rin67630/Soft-Power-MPPT/Hardware/Soft-Power Hardware Principles.md

# Soft-Power Hardware Principles

Instrumentation control is provided by:  
1. A convenience power output that can be controlled by software between 5V and 12V that can switched on and off by software as required. This can be used for any discretionary purpose by the user such as to charge a smaller secondary battery, control devices/track sun...
2. Two control lines for relays or FET-modules to switch user loads by software.
3. The analog input of the ESP8266 and enough processing capacity of the microcontroller remain available to include user-defined measurement functionalities.

## The hardware involved is using:

1. Several generally available buck converters, depending on panel size voltage, controlled by injecting voltage into their CV potentiometers to provide efficient power conversions.
2. An ESP8266 microcontroller to optimize solar panel power harvesting, control the buck converters and the charging process for various battery chemistries; and provide WiFi connectivity and a cloud statistical dashboard.
3. Relatively few connections with power measurement modules and other components make it possible to build the hardware without a PCB, using just a prototyping board.
4. The low cost materials should be procured for far less than $50.

## Schematic diagrams:

Unfortunately, there is no " one size fits all " hardware.  
There is currently no buck converter having at the same time a very low quiescent current, providing high power and being able to manage relatively high input voltage (see next chapter about converters used). For that reason, the design will consist of a base module, containing low-power, very low quiescent current buck converters, able to handling input power up to 20W.  
That base module can be used alone.  Cf: Soft Power 1xINA226 Minimum.pdf
To handle more power, an optional external buck converter can be added. The software will use the low-power modules in the low-power range and switch over to the more powerful buck converter as a power increases. Cf: Soft Power 1xINA3221 w Power Extension.pdf  
For people already having a SCC, but without Dashboard and extensive reporting abilities I provide a plain data logger. Cf. Soft Power 1xINA3221 Passive Logger.pdf.

All three hardware versions use the same base module. 

The operating concept is described in SoftPower Schematic Analysis.md

## Buck converters used:

The HW613 and D-SUN converter have a very low quiescent current, far below 1mA.
The HW613 buck converter is preferred in almost all respects, it is one of the few providing an "enable" input pad and is more easily tweaked to get CV injection, but it only supports an input voltage up to 24V.
The D-SUN buck converter accepts an input up to 40V which is required for 36Voc panels.

The "Fine" Red buck converter is a plain fixed 5V buck converter with the advantage of an inbuilt USB connector. It fits well under the Wemos module.
If the USB port is not a requirement, the smaller and more efficient HW613 modules can be used instead.

The SZBK07 buck converter is an option to boost the power from 20W to 300W for projects requiring more energy.
The HW636 buck converter is an option to boost the power from 20W to 250W and to manage panels up to 60Voc. 

## Preparation of the modules for injection:

The HW613 and D-SUN require soldering a wire to a really tiny trim potentiometer to allow voltage injection. That requires a bit of soldering experience and a fine tip. It is doable, even for an old man with some early signs of Parkinson.

1. HW613 - preferred for panels up to 24Voc
  
Another view on the module sowing better the injection point:  

2. D-SUN - for panels up to 40Voc

3. SZBK07 - mid-power option for up to 300W
  
4. HW636 - high voltage option for panels up to 60Voc 


## ESP8266 microcontroller:

You need to use an ESP8266, model 12E. The best is to use the Wemos D1 mini, which is the most convenient to use, since it has a smaller footprint and provide the ability to stack an OLED display on it.  
  
The D1 Mini exists also in the Pro-version, which provides more EEPROM and the possibility to use an external antenna. That more expensive version is recommended but not required.  
I have also made builds using the Lolin Node MCU and they are surely also doable using the Adafruit HUZZAH.

Almost all outputs of the ESP will be used:  
- D1 and D2 are providing the I2C functionality used by the power measurement module INA3221.
- D3 and D4 can control up to two relays or two FET modules to control power loads by software.
- D7 enables the convenience user power output.
- D8 enables the mid-power option when the charging power exceeds 15W.
- D0 enables U1, the low-power buck converter when the charging power is less than 15W (D0 has a specificity to be enabled automatically at power on).
- D6 is the PWM-output to control the voltage of the convenience user power output.
- D5 is the PWM-output to control the voltage of either U1 or U6, depending on the charging power.
- A0 is the 0 to 3V analog input left to the user for measuring tasks, or used to measure the panel voltage or the convenince output.

## OLED display option:

An oled display is nice to have. It adds only ~2 mA to the overall consumption.  
Two versions are supported:
a) The 64x48 pixel Wemos display hat, which conveniently can be just pushed on top of the WEMOS D1  
b) The bigger and more flexible 128x64 pixel display, which must be connected separately by connecting:  
-  Vcc to +3.3V
-  SCL to D1
-  SDA to D2
-  GND to GND

## INA3221 power measurement module:

The INA3221 power measurement module provides three independent measurement channels each of them consisting of voltage, current, power measurement.
- channel 1 is used to measure the photovoltaic module
- channel 2 is used to measure the main battery
- channel 3 is used to measure the convenience output/secondary battery.  
N.B. There are two different versions of INA3221 on the market. You should avoid the pink one, for which all three measurement channels are connected together at V+.  
The right black one is the right one to go, it has independent inputs and is also less expensive:  
 
N.B. The INA3221 has a measurement range from 0 to 1.5A with an accuracy of 0.5mA, which is fine for the operation up to 20W.  
For the extended power range up to 200W using a SZBK07 we will have to replace the shunts with 0.01 Ohm shunts resulting in a measurement range from 0 to 15A with an accuracy of 5mA.
If you want to push the SZBK07 to the theoretical maximum of 300W (20A), you can use 0.005 Ohm shunts, I would however recommend and prefer using an external shunt in that case.  

## INA226 power measurement module(s):
The INA226 power measurement module provides only one measurement channel, but they are more versatile.  
They support up to 36V as well can be easily purchased with either 0.1 Ohm or 0.01 Ohm shunts. 
The 0.1 Ohm version can handle a measurement range from 0 to 0.8A with an accuracy of 0.25mA, which is fine for the operation up to 10W.  
The 0.01 Ohm version can handle a measurement range from 0 to 8A with an accuracy of 0.25mA, which is fine for the operation up to 100W.
For an extended power range up to 200W using a SZBK07 we will have to replace the shunts with 0.005 Ohm shunts resulting in a measurement range from 0 to 15A with an accuracy of 5mA.

## Calculate the R4 resistance.
If you use the A0 input, to measure the panel voltage, you need a resitor R4 to reduce the voltage to the 0..3.2V input of the Wemos D1.
the rule to calculate that resistor is simple: 100K for every volt exceeding 3.2V. So if you want the panel range of 23.2V you put 20x100k=2M, if you want the panel range of 43.2V you put 40x100k=4M, which is not a standard, so you will use 3.9M instead, giving you a range of 0..42.2V.

### Addressing:  
If you use more than one module, you must provide different I2C addresses, by soldering a small tin bridge:  
  

### Increasing current measuring range:  
The original shunts can be relatively easy unsoldered by generously adding tin to both ends, then heating the ends in short sequence and shifting the resistor away with the soldering tip. You can do it! Even I can, as an old man with beginning Parkinson! 

## Current injection

The technique of current injection is described in document https://github.com/rin67630/Soft-Power-MPPT/blob/main/Hardware/About%20CV%20Injection.md. The bypass filter consists of a 6.8k or 8,2K resistor and a 1 or 10 microfarad condenser, the injection current resistor is a 500K trim potentiometer, which can be replaced by a fixed resistor, once the project is stable, currently the value is around 63K, excepted for the high voltage module which needs 3,3K.  

## Connectors

The prototyping board is equipped with following screw terminals :

**Left connector on INA3221**  
- Panel_in   negative.  
- Panel_in   positive.  
- Power_Output to SZBK Input positive

**Mid connector on INA3221** 
- Power_Input from Ideal Diode positive  
- Battery_Out positive  

**Right connector on INA3221**  
- Convenience output wo (does this mean without?) current monitoring positive  
- Convenience output with current monitoring positive  
- Convenience output negative  

**On Board**  
- Enable to SZBK07  
- CV Injection to SZBK07  

**I2C female header**  
- +3,3V  
- GND  
- SCL  
- SDA  

**2x Relay/FET control male headers**  
- 0 to 3.3V to control first relay  
- 0 to 3.3V to control second relay  
- Gnd.  
- +5V.  

**User defined measurement female header**  
- 0 to 3.3V analog input.  
- 0 to 3.3V to control first relay  
- Gnd  
- +5V.  

**12V Fan connector**

## Performance

- Quiescent current from the 12V battery ~25mA, mainly from the WiFi chip
- Low-Power Efficiency at 1W 92%
- Low-Power Efficiency at 10W 95%
- Mid Power Efficiency at 200W 97%

A reduction to <1mA at night could be realized with a sleep option.  
I do not want it for myself, since my user measurement functions on the same ESP8266 must go on permanently.

Enjoy!
