rin67630/Soft-Power-MPPT/Hardware/Open Hardware Link.md

https://oshwlab.com/lazlo.lebrun/soft-power-universal-pcb-prototype
