rin67630/Soft-Power-MPPT/Software/5_User Handbook Serial.md

# Operation on the serial line
The preferred operation -and by far the most powerful- runs in the cloud over Thinger.io.  
The precondition is however to have an Internet access. Without that I have provided a fallback operating mode over the serial line.   
The serial line is also the way to go upon problems with connecting to your dashboard.  
For that, you can connect the ESP over its USB port to a terminal program of your computer or of your smart phone.  

# Bootlog

## Successful
Upon starting the ESP you will get a boot log with diagnostic messages:  
```
0⸮~?⸮4⸮Ҷ
⸮⸮OAqr⸮⸮

ESP-Karajan at work,Serial @ 9600 Baud
Trying to connect

state: 5 -> 0 (0)
rm 0
del if0
usl
mode : null
mode : sta(d8:f1:5b:11:0e:ac)
add if0

.RSSI: 31 dBm
.RSSI: 31 dBm
.RSSI: 31 dBm
.RSSI: 31 dBm
.RSSI: 31 dBm
scandone
state: 0 -> 2 (b0)
.RSSI: 31 dBm
state: 2 -> 3 (0)
state: 3 -> 5 (10)
add 0
aid 5
cnt 

connected with [SSID], channel 1
dhcp client start...
ip:192.168.188.32,mask:255.255.255.0,gw:192.168.188.1
.RSSI: -53 dBm
OTA Ready
 MAC address: D8:F1:5B:11:0E:AC
Hostname: ESP-110EAC 
UDP ports: 4214, 4215
Now is Monday, 08 February 2021 21:42:32. Epoch =1612816952

pm open,type:2 0
```
_n.b.  
the gibberish first line is normal after a reboot._

Many lines are automatically generated, in between you however get interesting information:  
- RSSI: 31 dBm is generally the indication, that the connection on that frequency failed  
  RSSI: -53 dBm is a realistic radio level  
- ip:192.168.188.32 is a valuable information over the IP of your device.  
- Hostname: ESP-110EAC (not matching the hostname of your upload) means the Router has refused the host name, the reason for that is very probably,  
  that you already have another device with the same hostname in the network.  
- you only get the UDP ports listed if the operation was successful.  
- You only get the current date, if the ESP was able to reach the NTP server.  

## Unsuccessful
this is an example of an unsuccessful Wi-Fi connection attempt.  
```
ESP-Karajan at work,
Serial @ 9600 Baud
mode : sta(3c:61:05:d1:53:ce) + softAP(3e:61:05:d1:53:ce)
add if0

.....scandone
no wifihot found, reconnect after 1s
reconnect
.....SSID or PASS?
scandone
del if0
mode : softAP(3e:61:05:d1:53:ce)
running offline, back in the 70's
RSSI: 31 dBm
Now is 00:00:12. The Epoch is:         12
Date is Thursday, 01 January 1970
I need the date(dd/mm/yyyy) and time(hh:mm:ss)
```
In that case "no wifihot found" means, the SSID wifihot was not detected.  
Else it would list the router and attempt several connections, giving up after the third attempt, if your password does not match  
Another example with an existing SSID, but the wrong credentials:  
```
ESP-Karajan at work,Serial @ 9600 Baud
Trying to connect

mode : sta(d8:f1:5b:11:0e:ac)
add if0

.RSSI: 31 dBm
.RSSI: 31 dBm
.RSSI: 31 dBm
.RSSI: 31 dBm
.RSSI: 31 dBm
scandone
state: 0 -> 2 (b0)
.RSSI: 31 dBm
state: 2 -> 3 (0)
state: 3 -> 5 (10)
add 0
aid 1
cnt 
.RSSI: -51 dBm
.RSSI: -50 dBm
.RSSI: -52 dBm
.RSSI: -53 dBm
.RSSI: -52 dBm
.RSSI: -52 dBm
state: 5 -> 2 (2a0)
rm 0
.RSSI: 31 dBm
.RSSI: 31 dBm
reconnect
state: 2 -> 0 (0)
scandone
state: 0 -> 2 (b0)
state: 2 -> 3 (0)
state: 3 -> 5 (10)
add 0
aid 1
cnt 
.RSSI: -50 dBm
.RSSI: -50 dBm
.RSSI: -50 dBm
.RSSI: -51 dBm
.RSSI: -51 dBm
.

Bad SSID or PASS?
state: 5 -> 0 (0)
rm 0
del if0
usl
mode : null
force slp enable,type: 2
fpm open,type:2 0

Running offline, back in the 70's
Now is Thursday, 01 January 1970 08:00:18. Epoch =     28818

Please enter date & time (dd/mm/yyyy hh:mm:ss) in the serial monitor, followed by [return]
```
If the connection fails AND you never had an Internet connection and have no RTC shield, you will be requested to enter the current date and time, which is essential for proper operation of Soft-Power's statistic reports.  
You must then enter the date and time manually in order to proceed.  

The system answers with:  
```
I have understood 5/2/2021 18:48:0
Now is 18:48:00. The Epoch is: 1612464480
Date is Thursday, 05 January 2021
```
Now, your serial port is ready to receive commands.

In order to put the maximum of functionality into scarce memory of the microcontroller, there is no verbose menu.  
Instead you have a choice of single character commands, from which you can however enter several in one line, they will be executed in sequence.  

## One-shot reports

'S' Issues a status report, e.g.:  
```
Daily Report for 
Sunday, 07 February 2021 
Hour|   Ah    |    V    |    W    |
00  | -00.033 | +12.376 | -00.405 |
01  | -00.031 | +12.376 | -00.383 |
02  | -00.031 | +12.368 | -00.384 |
03  | -00.032 | +12.368 | -00.391 |
04  | -00.031 | +12.368 | -00.388 |
05  | -00.031 | +12.360 | -00.387 |
06  | -00.032 | +12.360 | -00.402 |
07  | -00.032 | +12.360 | -00.394 |
08  | -00.009 | +12.400 | -00.115 |
09  | +00.022 | +12.440 | +00.275 |
10  | +00.036 | +12.480 | +00.445 |
11  | +00.262 | +12.984 | +03.402 |
12  | +00.596 | +13.760 | +08.206 |
13  | +00.712 | +13.168 | +09.375 |
14  | +00.392 | +12.953 | +05.080 |
15  | +00.233 | +12.896 | +03.002 |
16  | +00.131 | +12.769 | +01.674 |
17  | -00.007 | +12.648 | -00.092 |
18  | -00.028 | +12.608 | -00.357 |
19  | -00.027 | +12.584 | -00.346 |
20  | -00.028 | +12.568 | -00.358 |
21  | -00.030 | +12.557 | -00.378 |
22  | -00.030 | +12.544 | -00.378 |
23  | -00.030 | +12.536 | -00.371 |
Extra hours 25:H-1, 26:today, 27:D-1, 28:D-2..
25  | -00.030 | +12.536 | -00.371 |
26  | +01.970 | +12.096 | +23.828 |
27  | +01.970 | +12.096 | +23.828 |
28  | +01.970 | +12.096 | +23.828 |
29  | +01.970 | +12.096 | +23.828 |
30  | +01.970 | +12.096 | +23.828 |
```
'T' Returns the time
```
Mon Feb  8 22:09:11 2021
```
In the example above, we already have used 's' an extender mentioning that you want to get a periodical report.  

## Periodical reports
Periodical reports can be printed every second, every minute, every hour, and even every day.  
They can also be used in the serial plotter from the Arduino IDE to generate time series graphs.  

### Setting the pace for periodical reports
The pace is given with a low case extender:  
's', 'm', 'h', 'd' staying for every second, minutely, hourly, daily.  
Once the pace for periodical reports is given, it stays valid for every report called after, until another pace is choosen or a '#' stop command is entered.  

### Periodical reports
currently the following periodical reports are available (more to come)
- 'E' Energy plot  
```
Ah:+00.000 Panel:-9.640 V-10:02.552 Amp:-0.029 Watt:-00.358
Ah:+00.000 Panel:-9.640 V-10:02.552 Amp:-0.029 Watt:-00.358
Ah:+00.000 Panel:-9.640 V-10:02.552 Amp:-0.029 Watt:-00.358
Ah:+00.000 Panel:-9.640 V-10:02.552 Amp:-0.029 Watt:-00.358
```
The same plot called from Arduino's IDE serial plotter:  
 
_n.b.  
The serial plotter of the Arduino IDE has only one Y-Axis range. In order to optimize the presentation, panel and battery voltages are issued -10 V: 3V means 13V..._

- 'W' Weather plot
Temp:-07.2 Hum:73.0 Press:1002 WindSpeed:5.7 Direction:50
Temp:-07.2 Hum:73.0 Press:1002 WindSpeed:5.7 Direction:50
Temp:-07.2 Hum:73.0 Press:1002 WindSpeed:5.7 Direction:50
Temp:-07.2 Hum:73.0 Press:1002 WindSpeed:5.7 Direction:50

- '~' returns a radio report
WiFi Plot :
Mode: STA
PHY mode: N
Channel: 1
AP id: 0
Status: 5
Auto connect: 1
SSID (10): [SSID]
Passphrase (8): [Password]
BSSID set: 0
's~' issues the same report, but followed with a signal strength line every second, so you can follow where you get the best (less negative) signal:

```
### Control commands
From the serial menu, you can control several operations of Soft-Power.

'+' or '-' increases or decreases in small steps the setpoint of the battery voltage
'>' or '<' increases or decreases in coarse steps the setpoint of the battery voltage
A0 stops the auxiliary output
A3.3 starts the auxiliary output at 3.3V (or any of the voltage specified up to 9.0V)

### Display control commands
You will be able to control which information is displayed on the OLED Display:  
- '0' switch of the display

t.b.continued.
