rin67630/Soft-Power-MPPT/Hardware/Sourcing.md

# Sourcing 

this file is given for convenience. I am not affiliated in any way with AliExpress, and do not even recommend them, but they have enough choice to be able to sell almost anything I have been using. Many items sell by quantities. If you are not tinkering a lot, you are probably better off buying locally just what you need.

Prototyping boards: https://www.aliexpress.com/item/32588853051.html  
Screw terminals: https://www.aliexpress.com/item/32807534570.html and https://www.aliexpress.com/item/1005001725925575.html  
Heat Sinks: https://www.aliexpress.com/item/32825341178.html and https://www.aliexpress.com/item/32825417247.html  

Low power buck converters: https://www.aliexpress.com/item/4000938525410.html  
or https://www.aliexpress.com/item/32979661350.html (less efficient, less powerful, but 40v input voltage instead of 24V of the HW613)  
60V buck converter: https://www.aliexpress.com/item/4001282565135.html  
High power buck converter: https://www.aliexpress.com/item/32933666759.html  
Ideal diode: https://www.aliexpress.com/item/32977096276.html  
Temperature switch: https://www.aliexpress.com/item/4000683400658.html  
Fan: https://www.aliexpress.com/item/32640103358.html (12v, 2pin)  
60V buck converter: https://www.aliexpress.com/item/32843426443.html

INA3221: https://www.aliexpress.com/item/4000480784866.html  
INA226 up to 0.8 A: https://www.aliexpress.com/item/33005541425.html  
or INA226 up to 8A https://www.aliexpress.com/item/32833590942.html  
High Power shunts: https://www.aliexpress.com/item/4001233004428.html  
SMD Shunts: https://www.aliexpress.com/item/32368758351.html   

Wemos D1 mini: https://www.aliexpress.com/item/32651747570.html  
or Wemos D1 mini Pro: https://www.aliexpress.com/item/1005001621776421.html  
64x48 pixel OLED: https://www.aliexpress.com/item/32801063529.html  
or 128x64 pixel OLED https://www.aliexpress.com/item/32796086867.html  

Resistor Kit 30 values: https://www.aliexpress.com/item/32475181535.html  
10uF capacitors: https://www.aliexpress.com/item/32952790541.html  
Trim potentiometers: https://www.aliexpress.com/item/1005001649630759.html

2 Channel Relay Module Board: https://www.aliexpress.com/item/4000418641261.html  
MOS Driver Module: https://www.aliexpress.com/item/1005001645129771.html  

Color wires: I use to tear-off old parallel printer or VGA cables from the scrapyard.  
They yet have good old quality copper wires, not the crap you buy today made of CC Aluminium!
