rin67630/Soft-Power-MPPT/Software/3_Configuration Instructions.md

# Configuration instructions
Warning: a few settings must interactivity match between the configuration at Thinger.io and the configuration file in the ESP.
So, if you are not an expert, may I strongly recommend not to change the username, nor to change the HOST_NAME unless you get familiar with the operation of the whole ecosystem.

The software is written in such a way that you can use it just upon defining your options in the folder a0_Parameters.  
If you are not familiar with the code, *this (and eventually Thinger_Dashboard) are the only folder that you should change*:  

## Parameter list
If you have several devices, change the HOST_NAME and let it be "Soft_Power", which must be matching the device name that you created at Thinger.io
The HOST_NAME also matches the device content of the default dashboard.  

Begin with populationg your credentials
#### WiFi credentials
If you already have successfully used your ESP device in your Wi-Fi network, you can skip that block, else...  

WifI: for the very first run with a new ESP or on a new WiFi network, remove the // from the next line and provide real SSID and PASS credentials. 

//#define ERASE_WIFI_CREDENTIALS 

Enter your Wi-Fi credentials 
´´´
#define ERASE_WIFI_CREDENTIALS 
#define WIFI_SSID          "SPLabs"
#define WIFI_PASS          "!Dev#45219"
#define wifiMaxTries       20
#define wifiRepeatInterval 500
´´´
Once you have made a successful connection to your Wi-Fi network, you can return to the configuration and restore the // from the next line. 
´´´
//#define ERASE_WIFI_CREDENTIALS 
´´´
this will speed up the next boot procedures, since it will not need to perform the credentials handshake anymore.
If you want you also can remove the sensitive information from your sketch.

#### Thinger.io credentials
The next step will be entering your credentials at Thinger.io:
´´´
#define THINGER_USERNAME           "SoftPower1"       
#define THINGER_DEVICE_CREDENTIALS "Device credentials"    
#define THINGER_DEVICE HOST_NAME   
´´´
n.b. please note the first line is your username, and the second one is the credentials of the device, *not the password of your web account* at Thinger.io.
Leave the third line unchanged it takes over the device hostname, that you defined right at the beginning of the configuration.

#### PoenWeatherMaps.org credentials
You should have opened a a free account at openweathermap.org, and have noted the map app ID.  
You can also search and call your city, then note its location ID "https://openweathermap.org/city/2928809" (the last number after the slash)  

Enter now these credentials together with your time zone information:  
#define OPEN_WEATHER_MAP_APP_ID      "208085abb5a3859d1e32341d6e1f9079"
#define OPEN_WEATHER_MAP_LOCATION_ID "2820158"
#define OPEN_WEATHER_MAP_LANGUAGE    "en"
#define OPEN_WEATHER_MAP_UNITS       "metric"

### Time zones
#define NTP_SERVER "de.pool.ntp.org"
#define MYTZ TZ_Europe_Paris
#define TZ   1                              // (utc+) TZ in hours

Then proceed with the hardware configuration:
### Hardware configuration
- #define WEATHER_SOURCE_IS_URL specifies that you get the weather information from an URL, the other options are given in the comment, so you also have the option to  
#define WEATHER_SOURCE_IS_NONE, if you do not want to process weather information.

- #define BATTERY_SOURCE_IS_INA specifies that to get the battery voltage and current from an INA-device, the other options being  
#define BATTERY_SOURCE_IS_UDP to get the battery information from another ESP as a slave device, or  
#define BATTERY_SOURCE_IS_NONE to not process battery information at all ( which only makes sense in my other projects ).

- #define PANEL_SOURCE_IS_A0 specifies that you get the panel voltage over A0 (that would be the case if you only have one INA226), the other options being  
#define PANEL_SOURCE_IS_INA if you are using an INA sensor for the panel (with INA3221 or at least two INA226) or  
#define PANEL_SOURCE_IS_URL to get the battery information from another ESP as a slave device and  
#define PANEL_SOURCE_IS_NONE to not process panel information at all ( which only makes sense in my other projects ).  

- #define AUX_SOURCE_IS_A0 specifies that you get the convenience voltage over A0 (that would be the case if you only have one INA226), the other options being  
#define AUX_SOURCE_IS_INA if you are using an INA sensor for the convenience  (with INA3221 or at least two INA226) or  
#define AUX_SOURCE_IS_URL to get/control the convenience information from another ESP as a slave device and   
#define AUX_SOURCE_IS_NONE to not process convenience information at all ( which only makes sense in my other projects or if you decides not to populate the convenience output).  

- #define BATTERY_IS_12V_FLA specifies that you are using a 12 V flooded acid battery, the other options being  
  #define BATTERY_IS_12V_AGM to use a 12 V AGM battery and so on...  
- #define DISPLAY_IS_OLED64x48 define if you are using an OLED display and which one.  
- #define DISPLAY_REVERSED if you're display should be used downunder (by Australians for example ;-)  

###Electrical parameters

Finally we need to enter the electrical parameters corresponding to your INA hardware:
Enter for each channel  the shunt value in microohm (R100 = 100 000)
Enter approximately the maximum value for your reading (this is only an order of magnitude below the library to optimize the non-floating-point operation)
- #define SHUNT0   100000    // Nominal Shunt resistor value in microOhm
- #define AMPERE0   2        // Chose here about 2x the max expected Amps
- #define SHUNT1   100000    // Nominal Shunt resistor value in microOhm
- #define AMPERE1   2        // Chose here about 2x the max expected Amps 
- #define SHUNT2   100000    // Nominal Shunt resistor value in microOhm
- #define AMPERE2   2        // Chose here about 2x the max expected Amps 

###Calibration

These settings to fine-tune your Soft-Power and increase accuracy.
You should leave the para meters unchanged, and perform later on a calibration procedure once everything is operative.

#define IFACTORP  1000000   // Panel Current correction factor 1000000 is normal,   -"- only used when PAN_SOURCE_IS_INA.
#define IFACTORB  1000000   // Battery Current correction factor 1000000 is normal,  -1000000 reverses shunt, change value to correct for wrong Amp values
#define IFACTORA  1000000   // Aux Out Current correction factor 1000000 is normal,   -"- only used when AUX_SOURCE_IS_INA.
#define PANEL_MAX 23300     // mV panel voltage  (Adjust to match panel voltage)
#define INJ_NEUTRAL 430
#define INJ_HP_MIN  00000   //   Minimum Battery Voltage Setpoint at injection=1024
#define INJ_HP_MAX  00000   //   Maximum Battery Voltage Setpoint at injection=0 
#define INJ_LP_MIN  10000   //   Minimum Battery Voltage Setpoint at injection=1024
#define INJ_LP_MAX  14830   //   Maximum Battery Voltage Setpoint at injection=0 
#define INJ_AUX_MIN  1870   //   Minimum Auxiliary Voltage Setpoint at injection=1024
#define INJ_AUX_MAX  8740   //   Maximum Auxiliary Voltage Setpoint at injection=0 

### Communication options
Do not change this block: (unless you know what you do. It is something for geeks)  
- #define THINGER            //(Comment out, if no thinger.io used)
- #define WRITE_BUCKETS      //(Comment out, if this is the second device for Thinger)
- //'define DWITTER          //(Comment out, if no dwitter.io used) 
- #define Console0 Serial    // Port for user inputs  
- #define Console1 Serial    // Port for user output
- #define Console2 Serial1   // Port for midnight report e.g. on thermal printer
- #define Console3 Serial    // Port for boot messages
- #define SERIAL_SPEED  9600 //9600  115200 230400
- //define PUBLISH_REPORT           // Issue events&midnight reports to UDP Port + 1, comment out else
- //#define PUBLISH_BATTERY         // If this is the battery master, comment out else
- #define UDP_TARGET "192.168.1.1"  // IP to forward data
- #define UDP_PORT   4214           // Port to forward data

That should be all for a first run...  
Compile and enjoy!

## Calibration procedure

if you are using shunts on board, that are smaller then R050, you should enter the correction factors for calibration (cf. hardware commissioning instructions, divisor rule of three, increasing factor reduces the display value)
- #define IFACTORP  1000000   // Panel Current correction factor 1000000 is normal,   -"- only used when PAN_SOURCE_IS_INA.
- #define IFACTORB  1000000   // Battery Current correction factor 1000000 is normal,  -1000000 reverses shunt, change value to correct for wrong Amp values  
- #define IFACTORA  1000000   // Aux Out Current correction factor 1000000 is normal,   -"- only used when AUX_SOURCE_IS_INA.
if you are measuring the panel voltage over A0, you should add the the correction factor for the panel voltage:  
- #define PANEL_MAX 23200     // mV panel voltage  (Adjust to match panel voltage, multiplying rule of three, increasing factor increases the display value)

Finally enter your injection factors (cf. hardware commissioning instructions)  
- #define INJ_NEUTRAL 400     //   PWM value that leads to the same voltages than adjusted without ESP.
- #define INJ_HP_MIN  11070   //   Minimum Battery Voltage Setpoint at injection=1024 (in mV)
- #define INJ_HP_MAX  15610   //   Maximum Battery Voltage Setpoint at injection=0  (in mV)
- #define INJ_LP_MIN  11040   //   Minimum Battery Voltage Setpoint at injection=1024 (in mV)
- #define INJ_LP_MAX  15560   //   Maximum Battery Voltage Setpoint at injection=0 (in mV)
- #define INJ_AUX_MIN  2750   //   Minimum Auxiliary Voltage Setpoint at injection=1024 (in mV)
- #define INJ_AUX_MAX  8550   //   Maximum Auxiliary Voltage Setpoint at injection=0 (in mV)
