rin67630/Soft-Power-MPPT/(threads)

Thread 3 (2021-01-20):

I just want to tell, there is someone doing the same with STM32

TeguhTeknisi, 2021-01-20:
Here the link https://github.com/szbeni/solar

Hardware main parts:
STM32 MCU (bluepill STM32F103)
SZBK07 DCDC module (LM25116 DCDC driver chip and other electroics removed just power electronic parts used)
250W solar panel 36V nominal voltage
Split charge relay for charging from engine, when driving (separate from this circuit)
55Ah and 110Ah 12V leisure batteries in parallel
3x ACS712 current sensors
ADS1115 ADC for current measurement
FAN for cooling power electronics
Bluetooth UART module for communnication

rin67630, 2021-01-20:
Thank you for the info.
He is using the PWM injection from https://github.com/farmerkeith/SolarChargerSZBK07ModuleV2
I found out, that a DC injection smoothed by a RC filter increases the efficiency of the buck converter.

TeguhTeknisi, 2021-01-20:
Your welcome.

Btw, i want to build Soft-Power-MPPT, because i have wemos d1, NodeMCU laying around,
But after read in here:
1. https://diysolarforum.com/threads/low-power-bad-weather-solar-harvesting-an-attempt-to-build-a-better-scc.13847/
2. https://diysolarforum.com/threads/an-attempt-to-build-a-better-scc-next-step.15023/
3. https://diysolarforum.com/threads/softpower-universal-version-for-panels-21w-and-panels-300w.16989

lookslike, i need to wait until its complete.
i hope you can make a youtube video for showing Soft Power MPPT in action with 100WP or 200WP.

Btw, I want to make Solar System with 100WP or 2 x 100WP plus 3S 18650 40A  i don't have the PV yet, still saving money.
Right now, i'am colecting Lithium 18650 battery, i took it from Pisen LCD Power Station 20.000mAH with 8 Battery inside.
i have 4 Pisen Power Bank 20.000mAh right now, still need more to buy.
( i found a video tutorial to take out the battery in here https://www.youtube.com/watch?v=YM6E39Lmwfo )

Thanks alot.

szbeni, 2021-01-20:
Hi!
I have tried using the PWM injection method to control the DC DC module, but it didn't give enough control for me over the power stage, so I added a gate driver chip and controlling the FETs with that instead of the LM25116 chip.
Beni

rin67630, 2021-01-20:
The DC injection gives -100%...+20%
That is perfect to control battery chargers.

Let us please continue on Discord:
Open Solar Project / Development [https://discord.com/channels/720686061159841852/792440881831608340](url)

TeguhTeknisi, 2021-01-20:
i never used discord for a long time ( since G Plus it shutdown ), i use it for chat with a farmer fellow in G Plus comunity.
so i reset the password, go to the link above, and "You find yourself in a strange place. .... "

i hope you can update the post in https://diysolarforum.com/threads/softpower-universal-version-for-panels-21w-and-panels-300w.16989/
i will follow in the forum and this github, so i can try to build it when you post the update in there.

Thanks a lot.

Closed 2021-01-20.

Thread 5 (2021-01-22):

Simplify Presentation

flywire, 2021-01-22:
Conceptually this is a very simple project but the presentation of many options is very complicated and confusing. This is unnecessary because most changes are component specifications requiring small circuit changes. It is suggested to explain common things simply before explaining the detail of the differences. Part of the problem is probably from designing the project in EasyEDA which does not support overlays like packages such as KiCad.

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
**Figure:** Overlay of all options demonstrating main changes are buck converter specifications and power sensors

The project converts solar panel power to battery power. Clearly identifying and describing the parts before the custom changes for different components would make it easier to understand. It would allow easy direct reference to components such as the Management Buck which powers the microcontroller. The Converter could be more simply described as usually a small buck and optionally a larger buck.

The schematic wiring would be clearer and more generic if the oled was placed next to the power sensors on the I2C bus. The detail is also inconsistent, for example, the blocking diode is shown but not temperature management and fusing.

flywire, 2021-01-23:
The text seems reasonable so the issue is how schematics communicate it:
1. schematics are ordered differently to text
1. changes are not obvious, maybe highlight changes from preferred option
1. difficult to compare one sheet with another
1. Add notes to schematics, eg: INA3221 module maximum of 26V, do not exceed "12V class" of panels (Voc=~20V, Vpp=~18V) or "12V" batteries.

rin67630, 2021-01-24:
OK, I will not change to Kicad in the middle of the development.
You are right I were just to creative... Let us just finish one version.
I will now just concentrate on the INA3221 version in the 12V class and issue an addendum for all possible variants.
The priority now is to document the hardware and finalize the software.

rin67630, 2021-01-24:
You are welcome to help me reforming the hardware documentation to shift all optional stuff at the end.
I must now solder...

flywire, 2021-01-24:
That's a good plan and good choice. I'll canvas some forums for good ideas to present designs with minor changes.

rin67630, 2021-01-25:
I have now profoundly revamped the schematics.
I just keep 3 variants:
The INA3221 full blown
The minimal version INA226 as device power supply
A Passive Logger.
The hardware tinkering is explained and the chip identifiers are consistent in pictures diagrams and layout.
I just must add a functional description.
Just take a look at the current state and give me feed-back.

flywire, 2021-01-29:
Portrait Block Diagram [code](http://interactive.blockdiag.com/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)

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

Landscape Block Diagram [code](http://interactive.blockdiag.com/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)

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

Enable legend in code if required.

Closed 2021-01-28.

Thread 12 (2021-02-03):

Dashboard Layout

flywire, 2021-02-03:
Layout
- Generally pretty good, most important information is V Bat then V Pan in centre top third of screen

Terms
- PV might be a more accepted abbreviation than Pan
- Aux is good, other documentation (including schematics) needs to be consistent

Colour
- pastels are nice on the eyes, yellow would be more naturally associated with PV

Setpoint
- use V rather than mV (regardless of source code) to be consistent with general usage and allow user to focus on number before or fraction after decimal

Gauges
- This is a hard way to interpret data compared to common digital V/A/W meters which often use three colours (eg red/green/blue) to display values
- percentage rather than value can be useful but probably not both at same time

Chart
- simple line charts are a good way of communicating information but things like 3d shading, which appears to be shown on the points, make data harder to interpret

Documentation
- Why is the data shown?  That explains how it is used.

rin67630, 2021-02-05:
Everybody can tailor it's own layout. I provided an example only.
Thinger.io is absolutely open with respect to that.
The only gotcha is that currently the setpoint is in mV in the ESP. I would have needed a conversion.

Closed 2021-02-05.

Thread 13 (2022-09-09):

issue in Soft-Power-MPPT/Software/e_Data.ino

trif55, 2022-09-09:
http.begin(WifiClient, OPEN_WEATHER_MAP_URL);

this line 173 i believe, gives an error, that error persists when changing WifiClient to WiFiClient and to WiFi

rin67630, 2022-09-20:
By the way this project is retired. It did not work reliably enough.

The software is now obsolete. The http library has also changed and require now instanciation.

amgednoomen, 2022-11-08:
Good

Closed 2022-09-20.
