rin67630/Soft-Power-MPPT/Hardware/Soft Power 1xINA226 Minimum.pdf

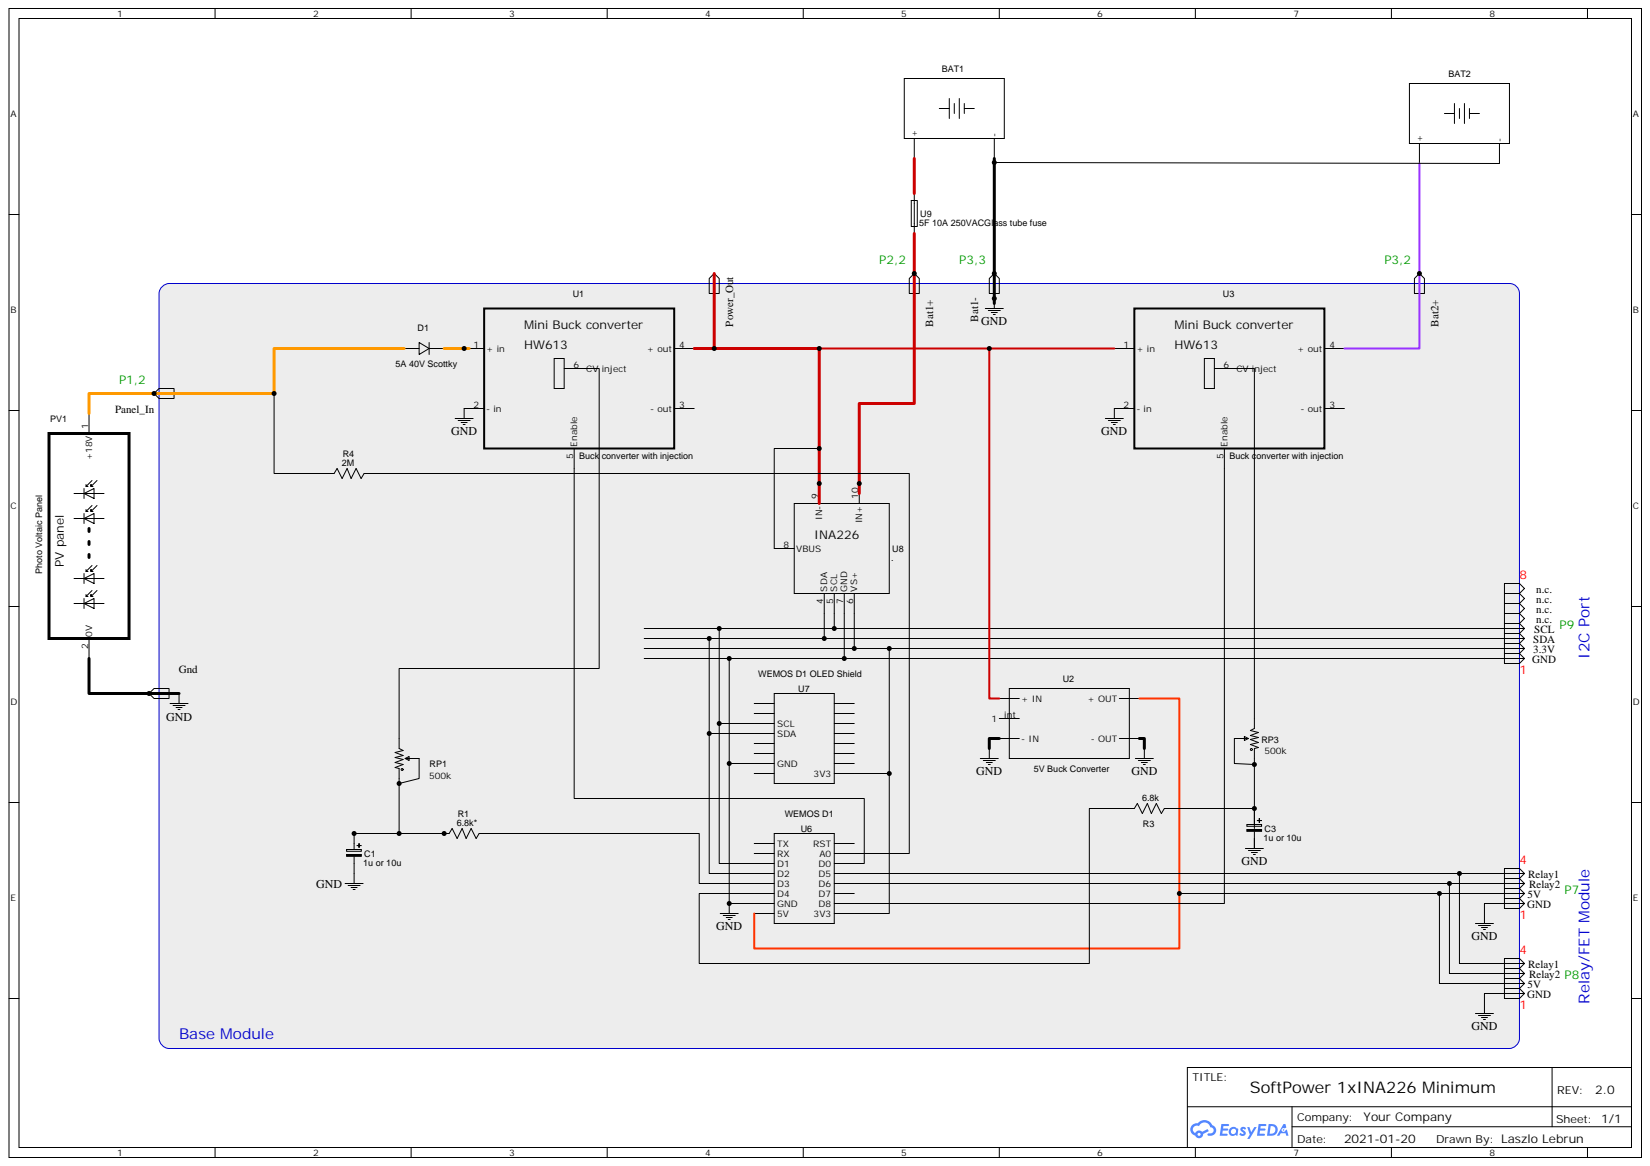
[picture p1: page 1]

Buck converter with injection

Drawn By: Laszlo Lebrun
