rin67630/Soft-Power-MPPT/Hardware/Soft Power 1xINA3221 Passive Logger.pdf

# MPPT SCC

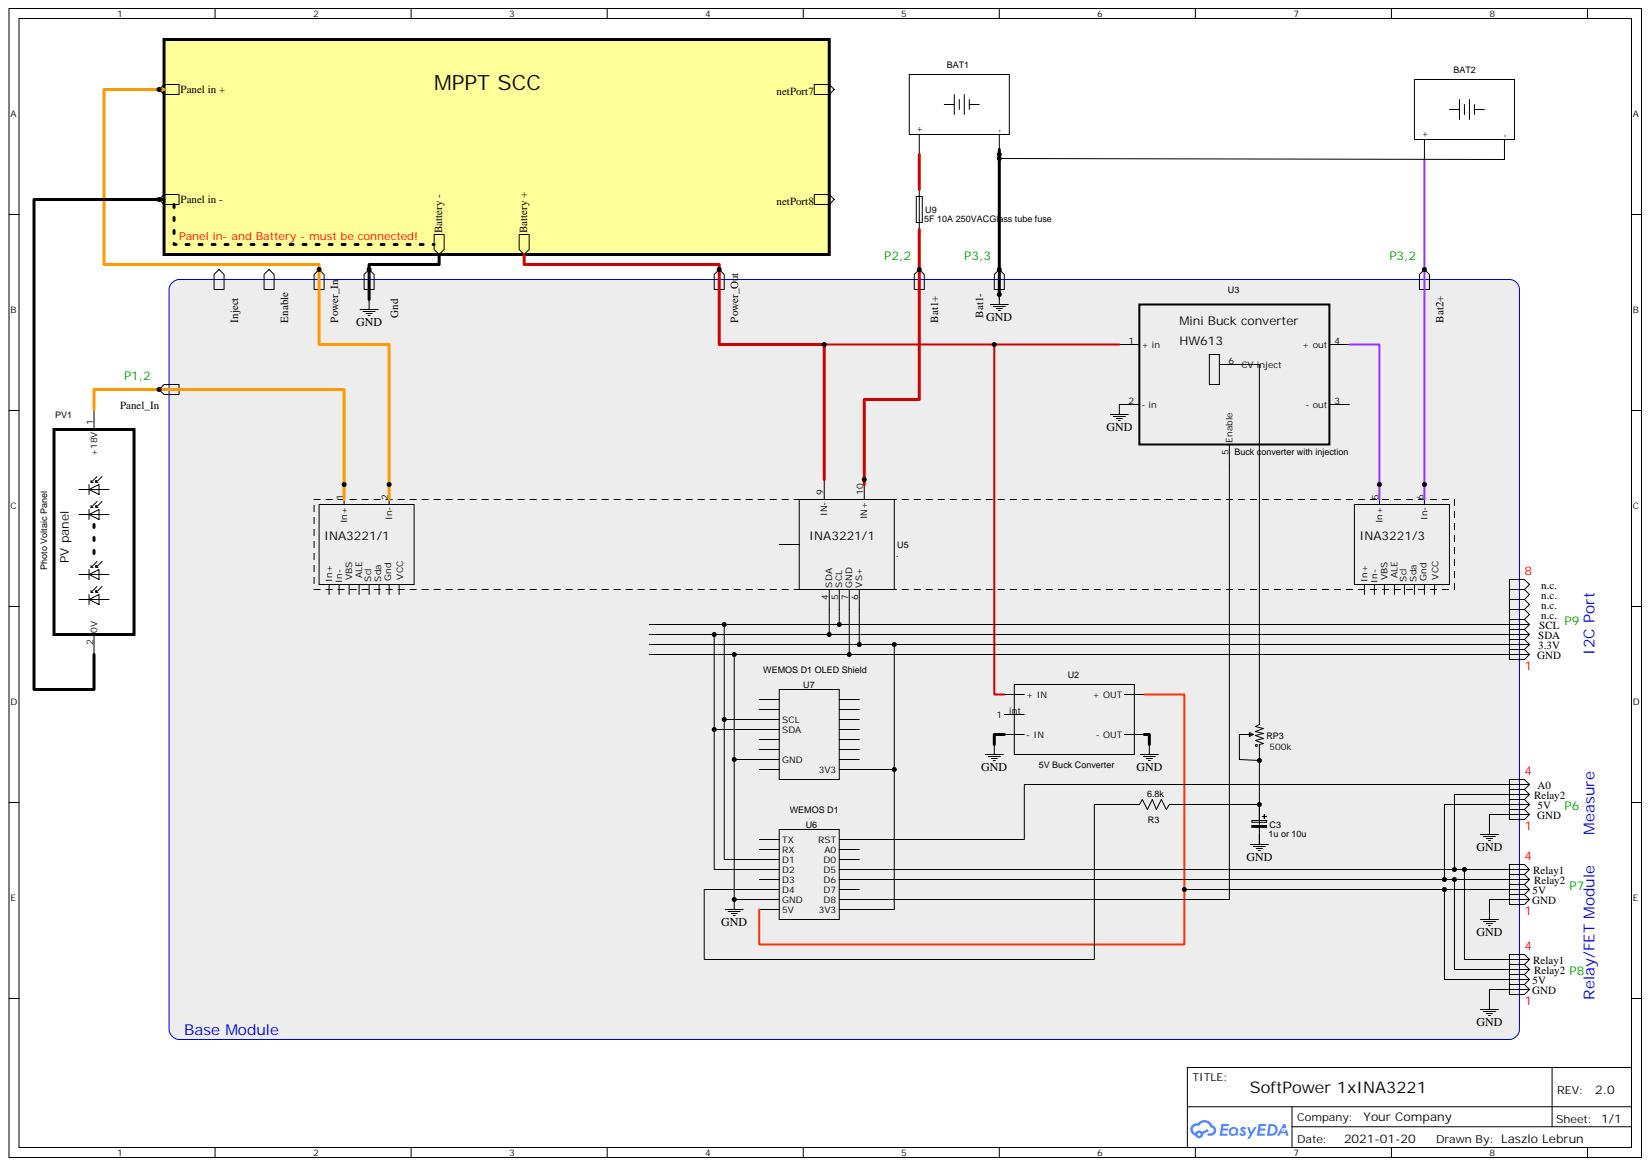
[picture p2: page 1]

Panel in- and Battery - must be connected! Power_In

Buck converter with injection

Relay/FET Module Measure

Drawn By: Laszlo Lebrun
