rin67630/Soft-Power-MPPT/Hardware/Soft Power 1xINA3221 w Power Extension.pdf

## Power Option

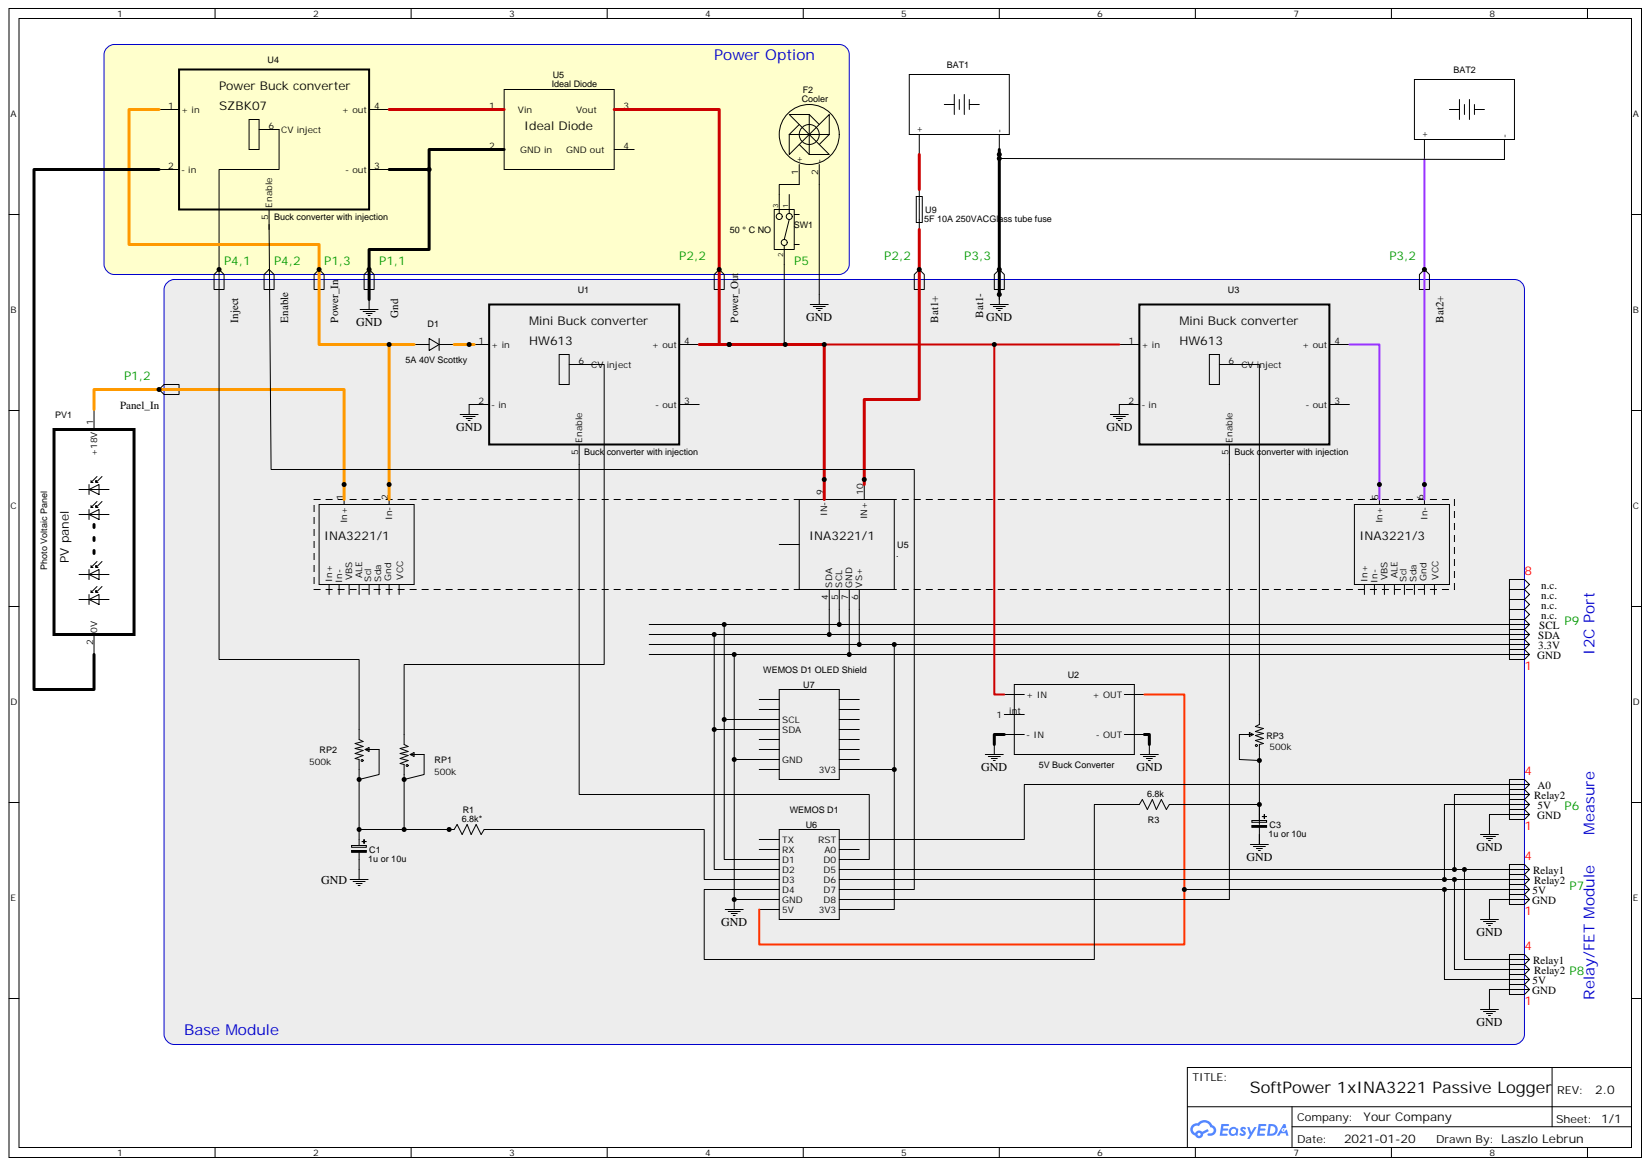
[picture p3: page 1]

Buck converter with injection

Relay/FET Module Measure

TITLE:
SoftPower 1xINA3221 Passive Logger REV: 2.0

Drawn By: Laszlo Lebrun
