rin67630/Soft-Power-MPPT/Software/SoftPowerMPPT_V5.ino

/* Target Hardware: ESP8266-12E

Soft Power MPPT
https://github.com/rin67630/Soft-Power-MPPT
The Allrounder in Reporting for Solar SCCs and converting plain buck converters into MPPT Solar Chargers.

License CC BY SA 3.0. (RIN67630)

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
*/
