rin67630/Soft-Power-MPPT/(commit log)

2020-11-04 Schematic diagram
    I used standard modules and made a first wiring with prototyping pcb's.
2020-12-09 Soft Power schematic
2020-12-23 8A for 100W panel in IP67 box
    8A buck converter with soft-MPPT for 100W panel in IP67 box and 150 AH lead-acid- battery
2021-01-04 Small presentation with pictures of the prototype
    Pictures of the prototype, schematic, component layout, buck converters used...
2021-01-04 Schematic diagram
2021-01-05 Create About CV Injection.MD
    Some theoretical and practical considerations about tweaking buck converters with current injection.
2021-01-05 Update About CV Injection.md
    Concepts and description of the injection technique to modify the output voltage of buck converters.
    Nice to read, if you want to understand how things work.
2021-01-15 Create SoftPower Schematic Analysis.md
2021-01-15 Update SoftPower Schematic Analysis.md
2021-01-18 now with 3 variants...
    This schematic now contains 3 variants
    1) the preferred variant with one INA-3221
    2) the variant with one INA-226
    3) the variant with two INA-226
2021-01-19 Update SoftPower Schematic Analysis.md
    adding a fourth variant for solar panels up to 60 V Voc
2021-01-19 Add files via upload
    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
2021-01-19 Add files via upload
    Added max volteges and D-Sun option for higher voltages.
2021-01-20 Written style
    Suggest rewrite Schematic Diagrams section in terms of functionality first then INA module usage.
2021-01-24 Update SoftPower Schematic Analysis.md
    Corrected some typos, increased consistency, increased clarity, corrected some values, added some useful additional information, reformulated some parts to keep it short and to the point.
    There is one ina3221 with 0.01r shunts available (but only from one seller), so I deleted that part.
2021-01-25 Update Sourcing.md
    Small correction, on all the websites it says input 4.5 to 24V not 28V.
2021-01-26 Update and rename SoftPower Schematic Analysis.md to Soft-Power Hardware Description.md
2021-01-26 Update and rename Soft-Power Hardware Description.md to Soft-Power Hardware Principles.md
2021-01-26 Update Soft-Power Hardware Principles.md
2021-02-28 Update e_Data.ino
    fixed deprecated HTTP:// call.
    [e_Data.ino]
